DiezelBrown/RC-Crawler-Control-Telemetry-Platform/hardware/README.MD

# Hardware

## Chassis & Structure
- Custom welded steel chassis
- 5/16 in steel tubing
- 3/16 in steel tubing
- Pothyes CNC aluminum center frame brace / skid plate / transmission mount

## Drivetrain
- INJORA complete SCX10 II gearbox transmission
- 13T pinion gear
- Alloy front steering axle with steel gears (SCX10 II)
- Alloy rear axle with steel gears (SCX10 II)
- MEUS Racing SCX10 II 313 mm link set
- HopsupRC steel driveshaft set (85–122 mm and 95–137 mm)
- HOPLEX heavy-duty driveshaft (125–185 mm)

## Suspension & Steering
- INJORA DRX 100 mm dual-rate oil shocks (4)
- LJWRC 30 kg waterproof digital steering servo

## Wheels & Tires
- 1.9 in aluminum beadlock wheels
- 4.61 in soft rubber crawler tires

## Power System
- HobbyFans S3650 4300KV brushless motor
- HobbyFans 60A waterproof brushless ESC
- ESC programming card
- OVONIC 2S 7.4V 5200 mAh 50C LiPo battery
- Buck converter (5V power for ESP32)

## Radio System
- DumboRC X4 transmitter
- DumboRC X6F receiver

## Telemetry System
- ESP32 DevKit V1
- Battery voltage sensor
- DS18B20 waterproof temperature sensor
- Hall-effect RPM sensor
- BNO055 IMU *(planned)*
- Bluetooth mobile application *(in development)*
- Custom telemetry PCB *(planned)*

## Fasteners & Hardware
- 25 mm mounting screws
- Assorted metric screws
- Lock nuts
- Servo horn
- Steering linkage hardware
- Shock mounting hardware

## Wiring & Electronics
- Breadboard (prototype)
- Jumper wires (prototype)
- Silicone wire *(planned)*
- JST connectors *(planned)*
