DiezelBrown/RC-Crawler-Control-Telemetry-Platform/mobile_app/rc_crawler_dashboard/README.md

# RC Crawler Telemetry Dashboard

Flutter mobile application for monitoring the Custom RC Crawler Telemetry System in real time.

## Features

- Live Bluetooth Low Energy (BLE) connection
- Vehicle speed display
- Wheel RPM monitoring
- Battery voltage
- Motor temperature
- Pitch and roll angle visualization
- Connection status indicator

## Hardware

- ESP32
- BNO055 IMU
- Hall Effect Sensor
- DS18B20 Temperature Sensor
- Battery Voltage Monitor

## Technologies

- Flutter
- Dart
- Bluetooth Low Energy (BLE)

## Status

🚧 In Development

Current version supports live telemetry from the ESP32.

Future updates:
- Data logging
- Battery percentage
- Multiple telemetry pages
- Firmware updates over BLE
