DiezelBrown/RC-Crawler-Control-Telemetry-Platform/hardware/pinout.md

# GPIO Assignments

| GPIO Pin | Function |
|---|---|
| GPIO34 | Battery Voltage Sensor |
| GPIO27 | DS18B20 Temperature Sensor |
| GPIO26 | Hall Effect Sensor |
| TBD | BNO055 SDA *(Planned)* |
| TBD | BNO055 SCL *(Planned)* |
