DiezelBrown/RC-Crawler-Control-Telemetry-Platform/docs/updates/2026-06-30-roll-cage-completed.pdf

Project Update – June 30, 2026

Today I completed the fabrication of the roll cage for my custom RC crawler. With the structural components now finished, I am beginning development of the telemetry system before permanently mounting the roll cage to the chassis. This approach provides easier access to electronics, wiring, and sensors during testing and debugging.

The next phase of the project will focus on integrating an ESP32 microcontroller with sensors to monitor key vehicle data such as motor RPM, battery voltage, speed, and motor temperature. Once the telemetry hardware and software have been tested and verified, I will permanently mount the roll cage and complete the final electronics installation.

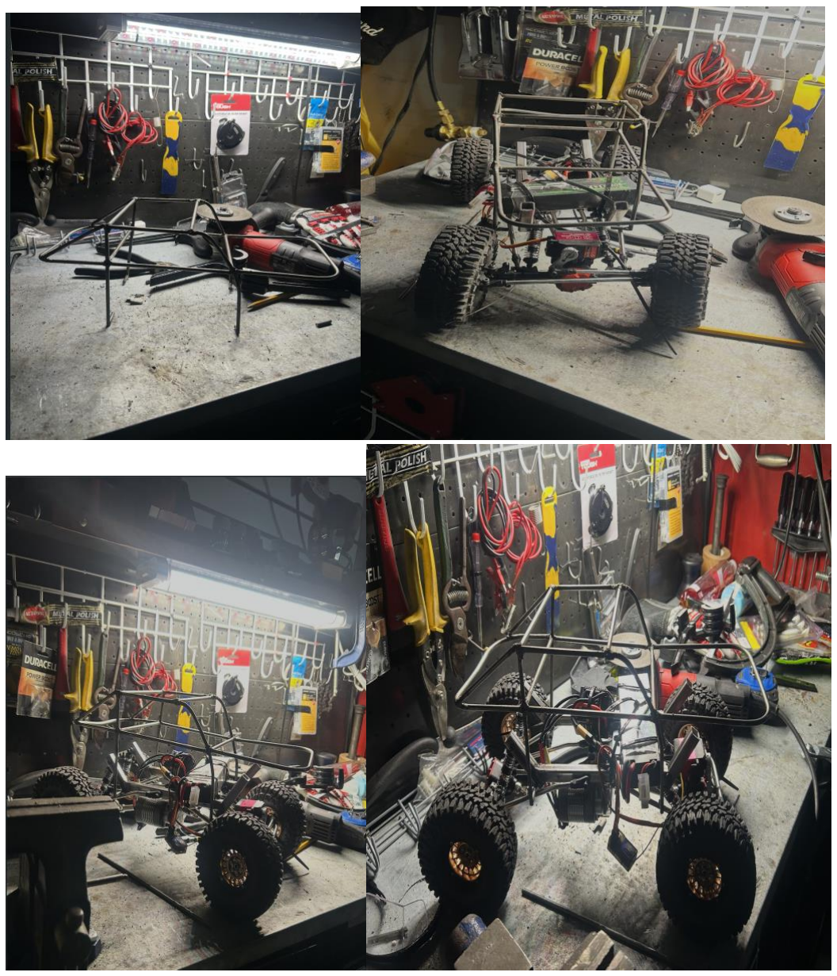
[picture p7: figure]
