DiezelBrown/RC-Crawler-Control-Telemetry-Platform/photos/early-development-roll-cage.jpeg

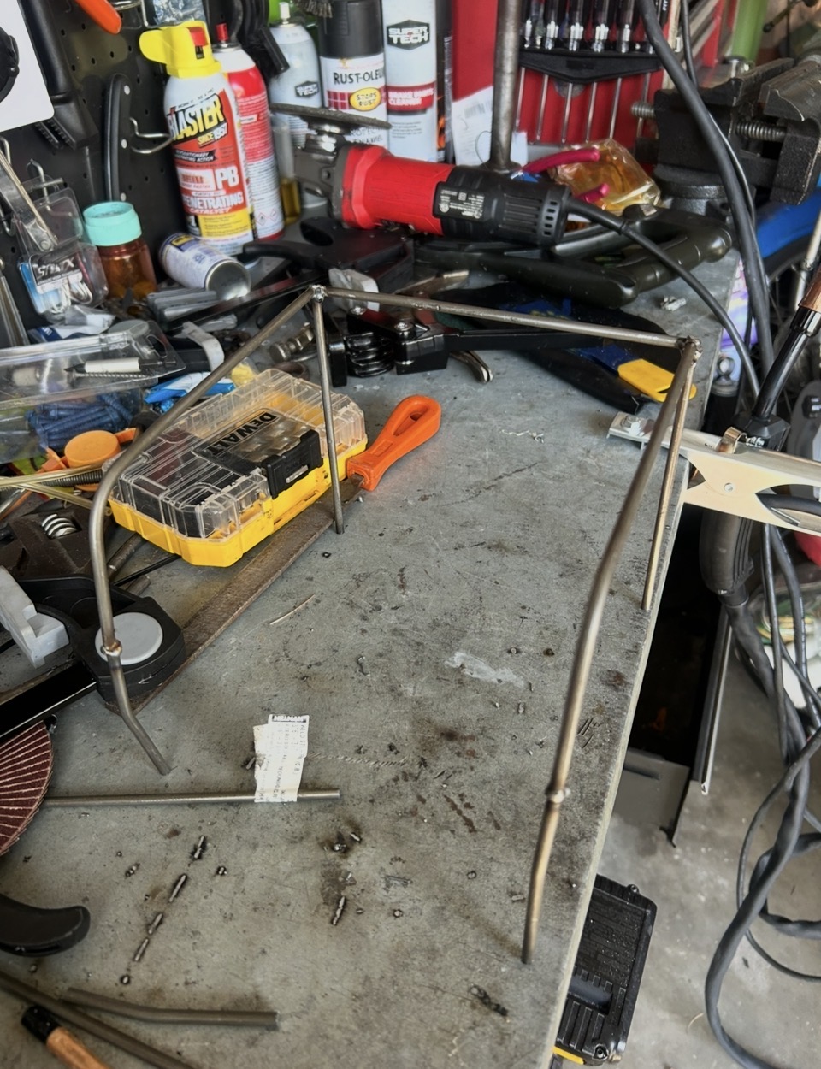
photos/early-development-roll-cage.jpeg
