DiezelBrown/RC-Crawler-Control-Telemetry-Platform/photos/IMG_4010.jpeg

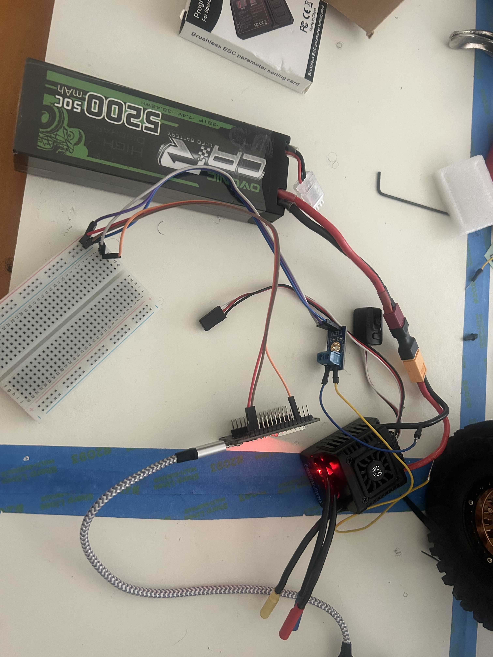
photos/IMG_4010.jpeg
