DiezelBrown/RC-Crawler-Control-Telemetry-Platform/photos/IMG_4015.jpeg

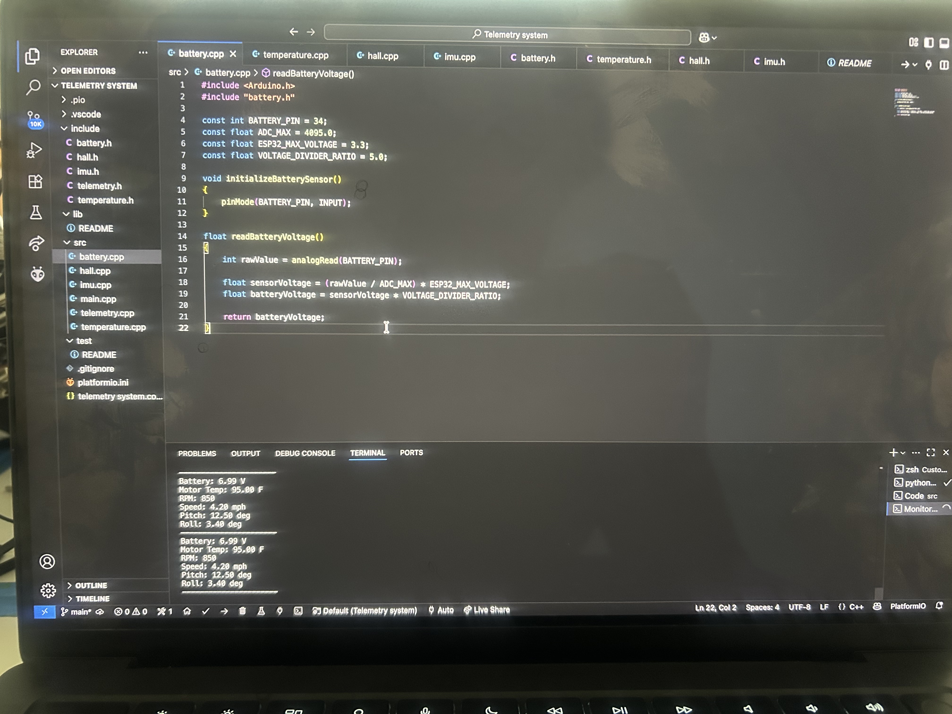
photos/IMG_4015.jpeg
