DiezelBrown/RC-Crawler-Control-Telemetry-Platform/photos/kicad-pcb-design-01.jpeg

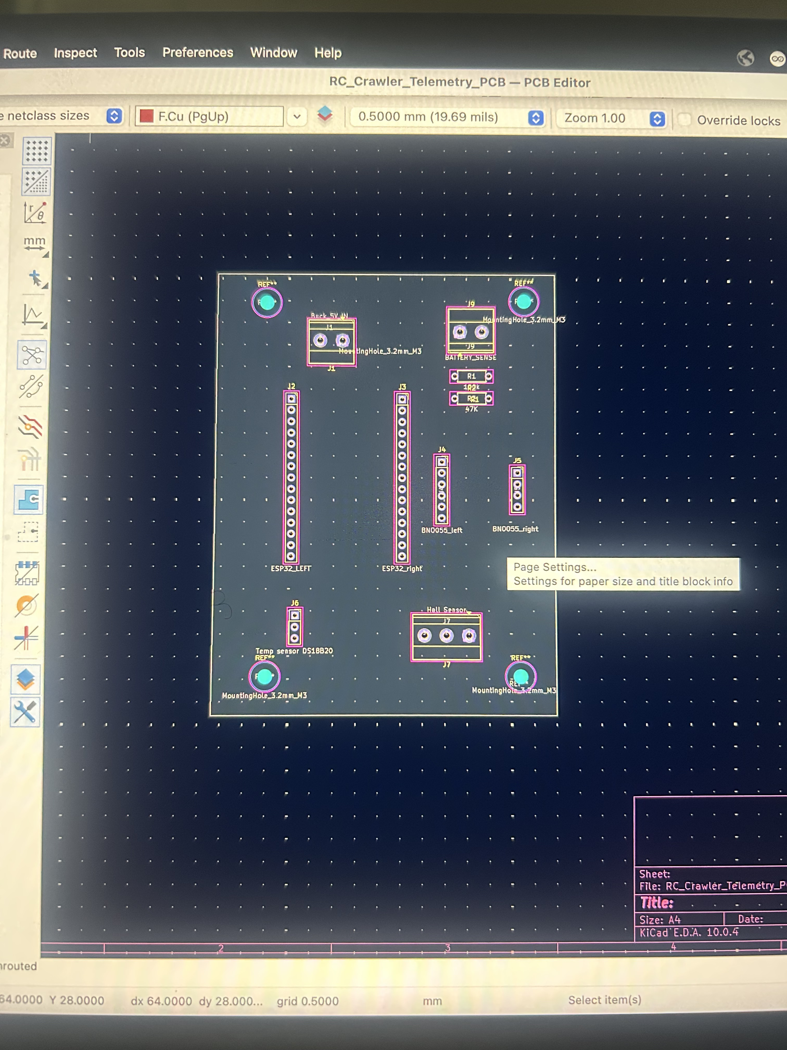
photos/kicad-pcb-design-01.jpeg
