DiezelBrown/RC-Crawler-Control-Telemetry-Platform/photos/layout.jpg

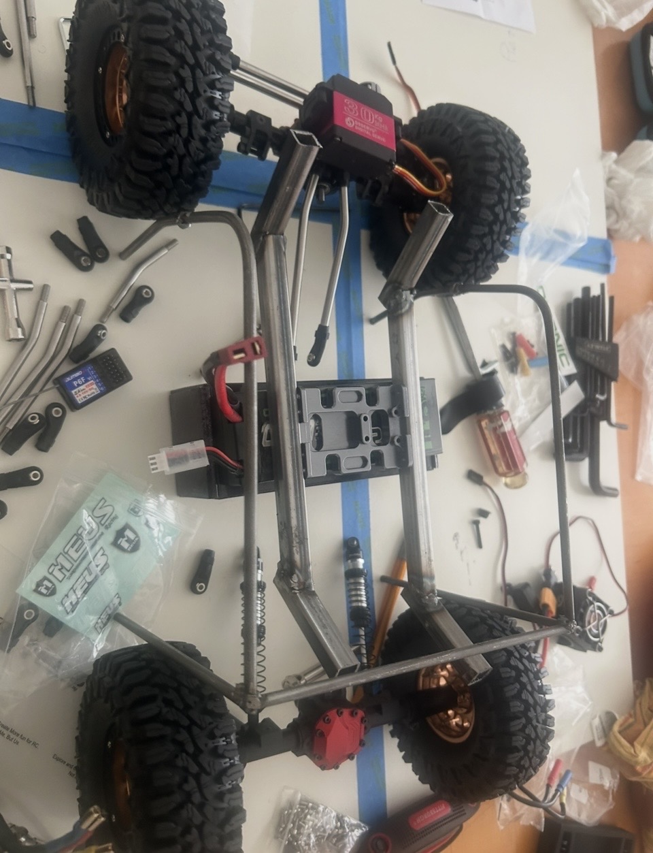
photos/layout.jpg
