DiezelBrown/RC-Crawler-Control-Telemetry-Platform/photos/Transmission.jpg

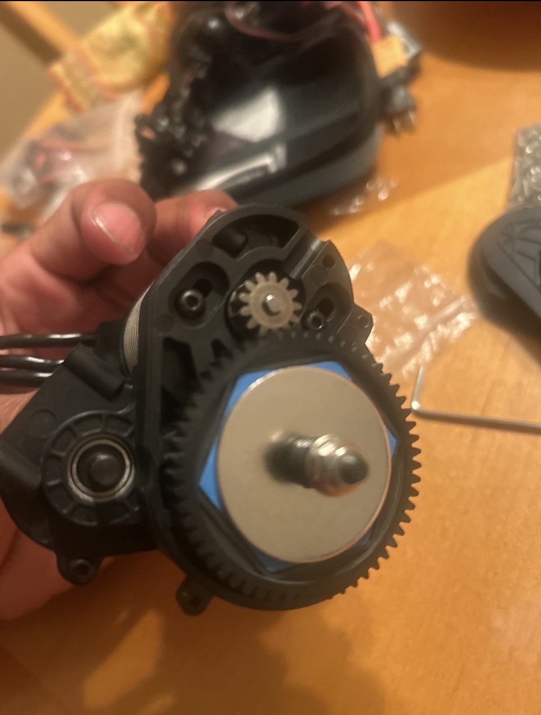
photos/Transmission.jpg
