DiezelBrown/RC-Crawler-Control-Telemetry-Platform/hardware/BOM.md

# Bill of Materials (BOM)

This document lists the major components used to build the Custom RC Crawler Telemetry System.

---

# Chassis & Structure

| Component | Description | Status |
|---|---|---|
| Steel Chassis | Custom welded steel chassis | Installed |
| Steel Tubing | 5/16 in steel tubing | Installed |
| Steel Tubing | 3/16 in steel tubing | Installed |
| Center Frame Brace | Pothyes CNC aluminum center frame brace / skid plate / transmission mount | Installed |

---

# Drivetrain

| Component | Description | Status |
|---|---|---|
| Transmission | INJORA SCX10 II complete gearbox | Installed |
| Pinion Gear | 13T steel pinion gear | Installed |
| Front Axle | Alloy steering axle with steel gears (SCX10 II) | Installed |
| Rear Axle | Alloy axle with steel gears (SCX10 II) | Installed |
| Link Set | MEUS Racing SCX10 II 313 mm links | Installed |
| Driveshaft | HopsupRC steel driveshaft set | Installed |
| Driveshaft | HOPLEX heavy-duty driveshaft | Installed |

---

# Suspension & Steering

| Component | Description | Status |
|---|---|---|
| Shocks | INJORA DRX 100 mm dual-rate oil shocks (4) | Installed |
| Steering Servo | LJWRC 30 kg waterproof digital servo | Installed |

---

# Wheels & Tires

| Component | Description | Status |
|---|---|---|
| Wheels | 1.9 in aluminum beadlock wheels | Installed |
| Tires | 4.61 in soft rubber crawler tires | Installed |

---

# Power System

| Component | Description | Status |
|---|---|---|
| Motor | HobbyFans S3650 4300KV brushless motor | Installed |
| ESC | HobbyFans 60A waterproof brushless ESC | Installed |
| Programming Card | HobbyFans ESC programming card | Installed |
| Battery | OVONIC 2S 7.4V 5200mAh 50C LiPo | Installed |

---

# Radio System

| Component | Description | Status |
|---|---|---|
| Transmitter | DumboRC X4 | Installed |
| Receiver | DumboRC X6F | Installed |

---

# Telemetry Electronics

| Component | Description | Status |
|---|---|---|
| Microcontroller | ESP32 DevKit V1 | Installed |
| Battery Sensor | Battery voltage sensor module | Installed |
| Temperature Sensor | DS18B20 waterproof sensor | Installed |
| RPM Sensor | Hall-effect sensor | Installed |
| Breadboard | Prototype wiring | Installed |
| IMU | BNO055 orientation sensor | Planned |
| Buck Converter | 5V regulator for ESP32 | Planned |
| Custom PCB | Telemetry PCB | Planned |

---

# Fasteners & Hardware

| Component | Description | Status |
|---|---|---|
| Screws | 25 mm mounting screws | Installed |
| Fasteners | Assorted metric screws | Installed |
| Lock Nuts | Metric lock nuts | Installed |
| Steering Hardware | Servo horn and steering linkage | Installed |
| Shock Hardware | Shock mounting hardware | Installed |
