DiezelBrown/RC-Crawler-Control-Telemetry-Platform/photos/assembled-pcb.jpeg

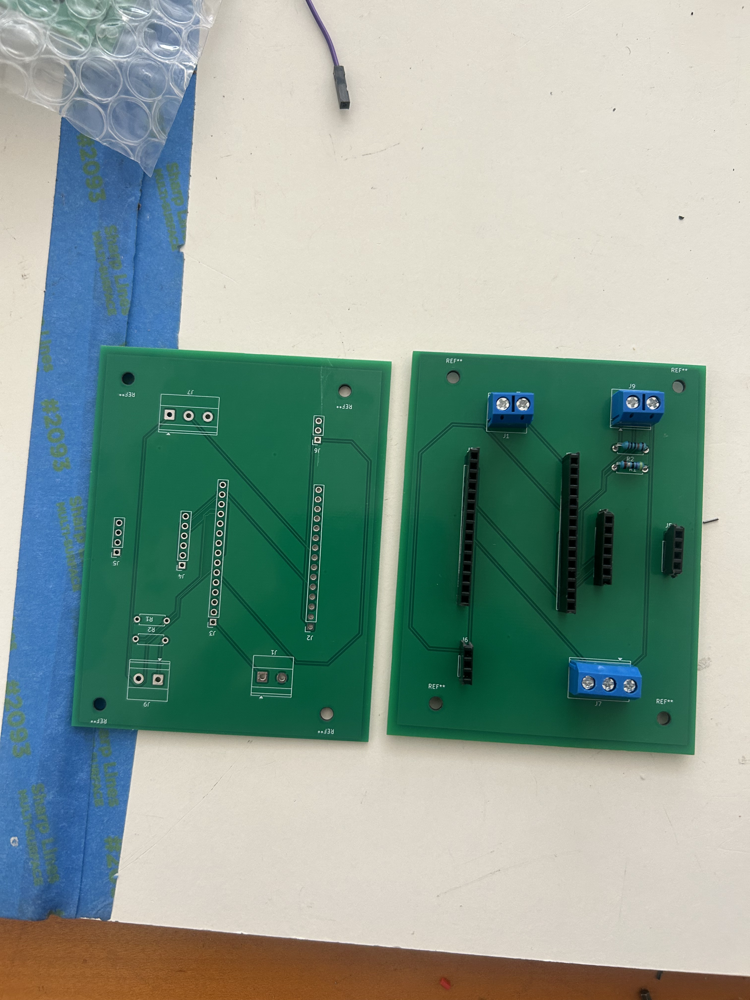
photos/assembled-pcb.jpeg
