DiezelBrown/RC-Crawler-Control-Telemetry-Platform/photos/Wiring.jpeg

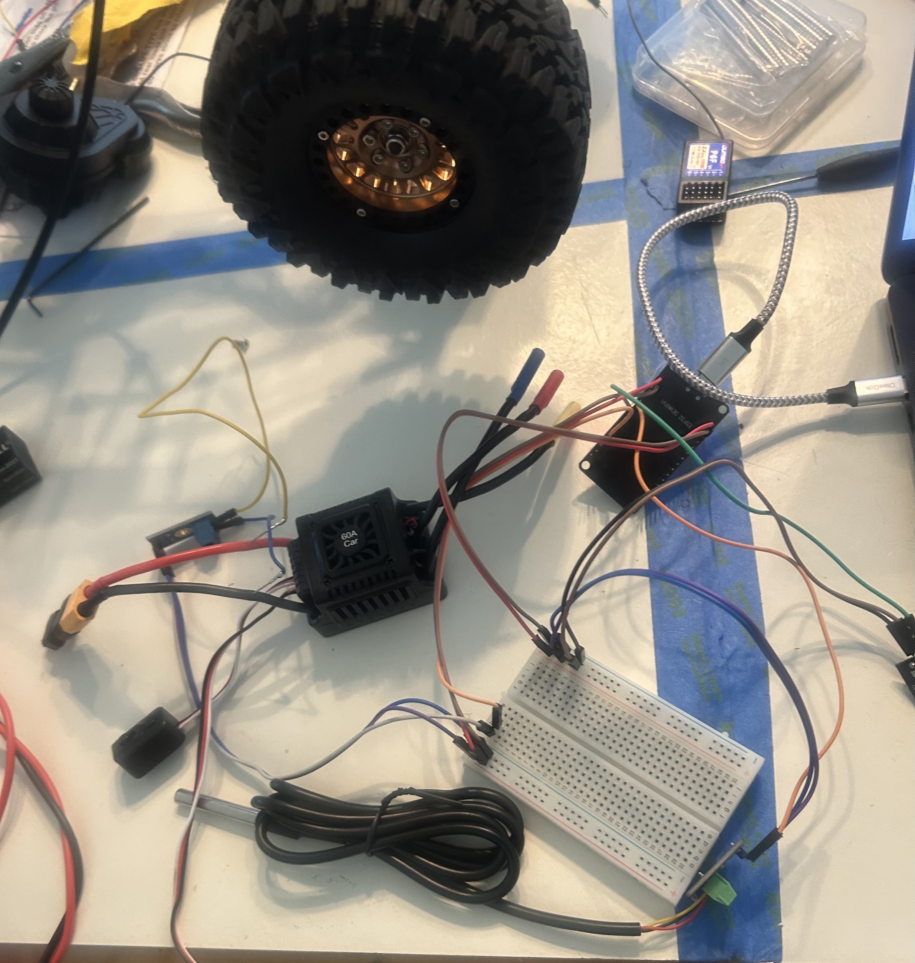
photos/Wiring.jpeg
