DiezelBrown/RC-Crawler-Control-Telemetry-Platform/docs/updates/2026-06-29-drivetrain-testing.pdf

## June 29, 2026 – First Driving Test

Today, I completed the first successful driving test of the RC crawler. The vehicle is currently operating in 2WD and is driven in reverse because the motor was mounted in an alternate orientation to accommodate the steep front driveshaft angles.

This test confirmed that the drivetrain, steering, and suspension systems are functional while identifying several areas for improvement. The primary objectives moving forward are to optimize the drivetrain layout, restore normal forward operation, and complete the transition to a fully functional 4WD drivetrain.

## Key Lessons Learned

- The current drivetrain configuration operates reliably but requires reverse motor orientation.
- Drivetrain geometry has a significant impact on driveshaft operating angles.
