DiezelBrown/RC-Crawler-Control-Telemetry-Platform/hardware/PCB/RC_Crawler_Telemetry_PCB/RC_Crawler_Telemetry_PCB.kicad_pcb

## KiCad design hardware/PCB/RC_Crawler_Telemetry_PCB/RC_Crawler_Telemetry_PCB.kicad_pcb (2026-07-17)

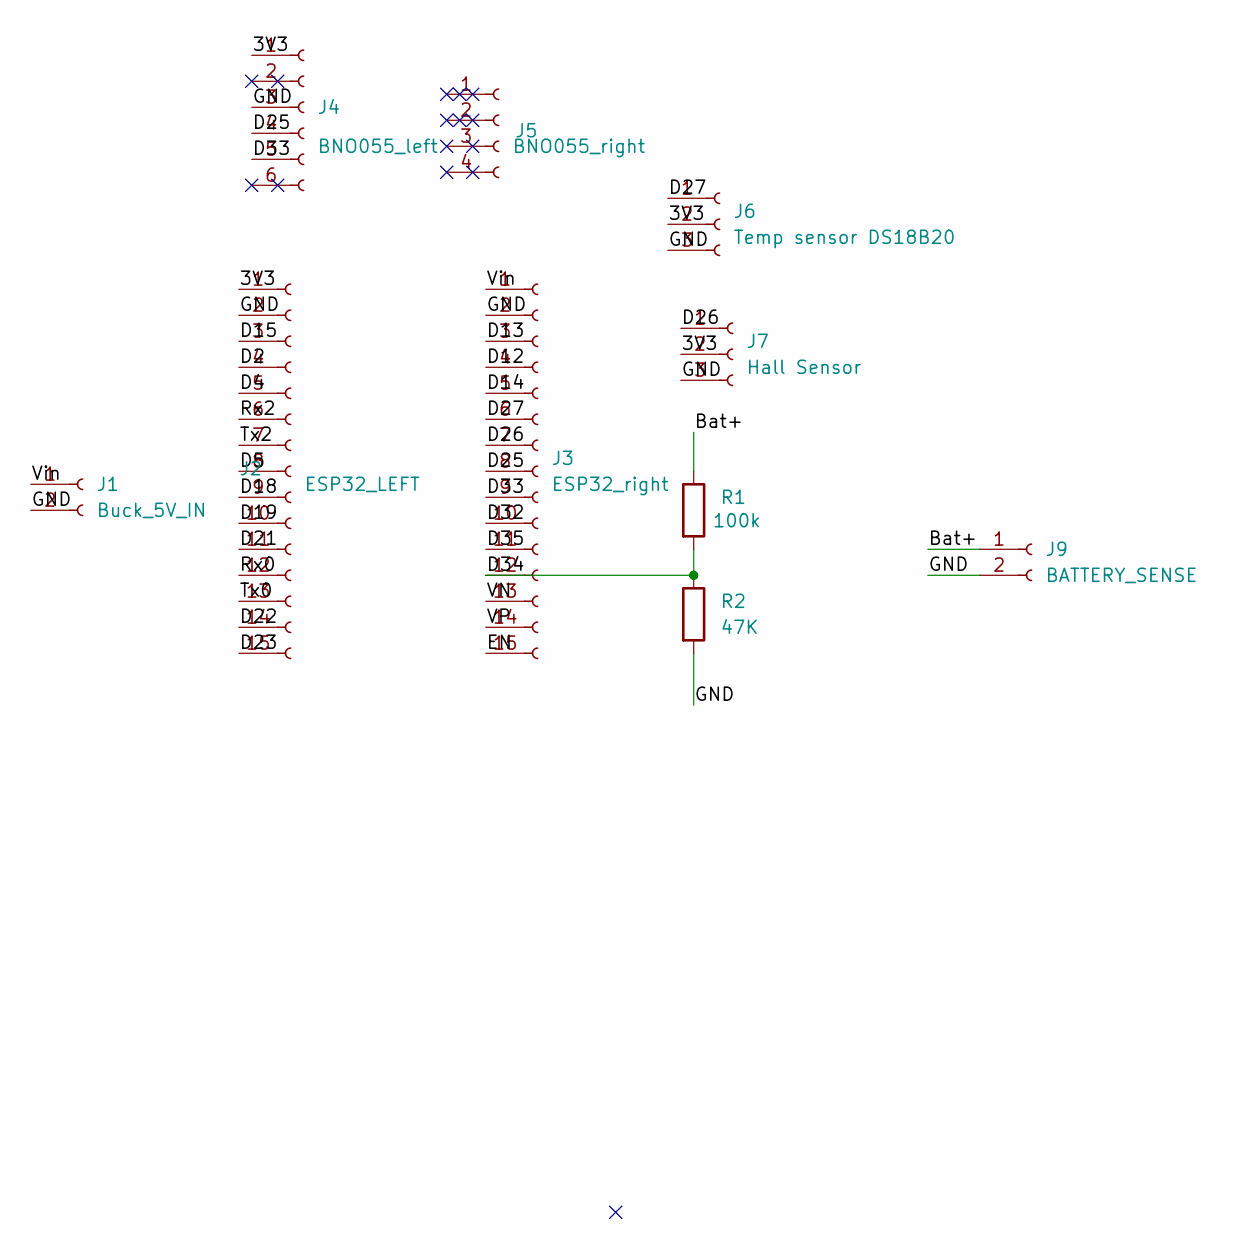
[picture p17: schematic RC_Crawler_Telemetry_PCB.kicad_sch]

Parts:
J1: Buck_5V_IN; TerminalBlock_Phoenix_MKDS-1,5-2_1x02_P5.00mm_Horizontal
J2: ESP32_LEFT; PinSocket_1x15_P2.54mm_Vertical
J3: ESP32_right; PinSocket_1x15_P2.54mm_Vertical
J4: BNO055_left; PinSocket_1x06_P2.54mm_Vertical
J5: BNO055_right; PinSocket_1x04_P2.54mm_Vertical
J6: Temp sensor DS18B20; PinSocket_1x03_P2.54mm_Vertical
J7: Hall Sensor; TerminalBlock_Phoenix_MKDS-1,5-3_1x03_P5.00mm_Horizontal
J9: BATTERY_SENSE; TerminalBlock_Phoenix_MKDS-1,5-2_1x02_P5.00mm_Horizontal
R1: 100k; R_Axial_DIN0207_L6.3mm_D2.5mm_P7.62mm_Horizontal
R2: 47K; R_Axial_DIN0207_L6.3mm_D2.5mm_P7.62mm_Horizontal

Connections:
/3V3: J2.1, J4.1, J6.2, J7.2
/Bat+: J9.1, R1.1
/D2: J2.4
/D4: J2.5
/D5: J2.8
/D12: J3.4
/D13: J3.3
/D14: J3.5
/D15: J2.3
/D18: J2.9
/D19: J2.10
/D21: J2.11
/D22: J2.14
/D23: J2.15
/D25: J3.8, J4.4
/D26: J3.7, J7.1
/D27: J3.6, J6.1
/D32: J3.10
/D33: J3.9, J4.5
/D34: J3.12, R1.2, R2.1
/D35: J3.11
/EN: J3.15
/GND: J1.2, J2.2, J3.2, J4.3, J6.3, J7.3, J9.2, R2.2
/Rx0: J2.12
/Rx2: J2.6
/Tx0: J2.13
/Tx2: J2.7
/VN: J3.13
/VP: J3.14
/Vin: J1.1, J3.1

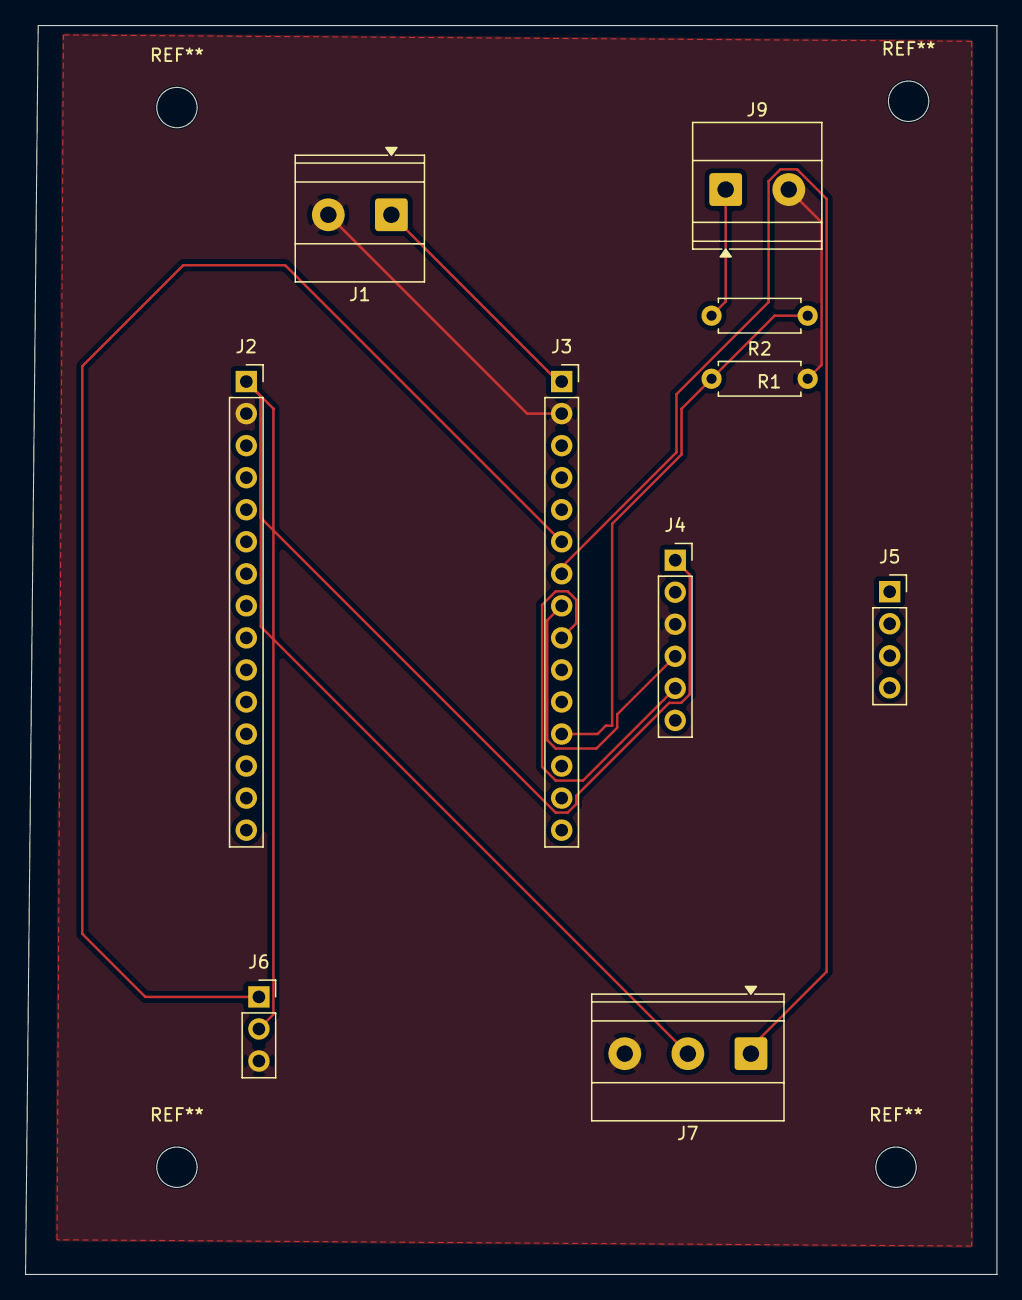
[picture p18: board RC_Crawler_Telemetry_PCB.kicad_pcb from above]

Board: 2 copper layers, 77.0 x 99.0 mm, 10 parts (0 on the bottom side), 9 nets.
