DiezelBrown/RC-Crawler-Control-Telemetry-Platform/(commit log)

2026-06-16 Update .gitignore for ESP32 C project
2026-06-16 Add parts list and assembly notes for RC crawler
    Add hardware directory
2026-06-16 Project documentation, wiring diagrams, testing results, and development notes.
2026-06-16 Create READ.ME
    Project documentation, wiring diagrams, testing results, and development notes.
2026-06-17 Early development
    Chassis development and layout
2026-06-22 Update README with parts list and assembly notes
    Added detailed parts list and assembly notes for the RC crawler, including chassis, drivetrain, suspension, electronics, and planned telemetry system.
2026-06-22 suspension installed
    In the photos I only have the front axle working Im going to install a longer rear driveshaft and then will begin working on my roll cage again
2026-06-22 Update README with RC crawler details and telemetry system
    Added detailed sections for chassis, drivetrain, suspension, wheels, electronics, telemetry system, and hardware.
2026-06-30 test run 6/29
    Today I was able to do the first full test run with my rc car. I the car right now is only running in 2wd and driving in reverse due to the motor having to be mounted differently due to the steep drive shaft angles.
2026-06-30 First test run 6/29
    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
2026-07-05 Revise current status section in README
    Updated project status with completed tasks and pending integrations.
2026-07-05 Add PlatformIO telemetry firmware framework
2026-07-07 Add live battery voltage telemetry module
2026-07-07 images of testing voltage sensor
2026-07-08 Wiring with breadboard
    Just testing components
2026-07-08 Rename IMG_4016.jpeg to Voltage_sensor_test .jpeg
2026-07-08 Revise hardware README structure and content
    Updated README to reflect new hardware and system organization, including sections for Power System, Radio System, and Telemetry System.
2026-07-08 Add Bill of Materials for Custom RC Crawler
    Added a comprehensive Bill of Materials (BOM) for the Custom RC Crawler Telemetry System, detailing components used in various categories including chassis, drivetrain, suspension, power system, radio system, telemetry electronics, and fasteners.
2026-07-08 Add Wiring Guide for ESP32 telemetry system
    This document outlines the wiring connections for the ESP32 telemetry system, including details for various sensors and the planned PCB design.
2026-07-10 Revise README for better structure and clarity
    Updated README to enhance clarity and organization of features, technologies, current telemetry, repository structure, status, and future goals.
2026-07-14 Update project status for mobile app and PCB
2026-07-14 Revise project status in README
    Updated the status of the mobile application and custom KiCad PCB.
2026-07-15 Start KiCad telemetry PCB design
    [RC_Crawler_Telemetry_PCB.kicad_pcb, RC_Crawler_Telemetry_PCB.kicad_sch]
2026-07-15 Add sensor interfaces and battery monitoring circuit
    [RC_Crawler_Telemetry_PCB.kicad_sch]
2026-07-17 Complete first revision of telemetry PCB
    [RC_Crawler_Telemetry_PCB.kicad_pcb, RC_Crawler_Telemetry_PCB.kicad_sch]
2026-07-17 KiCad PCB
2026-09-17 Update telemetry function for final sensor implementation
2026-09-17 Integrate final sensor and BLE telemetry firmware
