DiezelBrown/RC-Crawler-Control-Telemetry-Platform/photos/kicad-pcb-design-02.jpeg

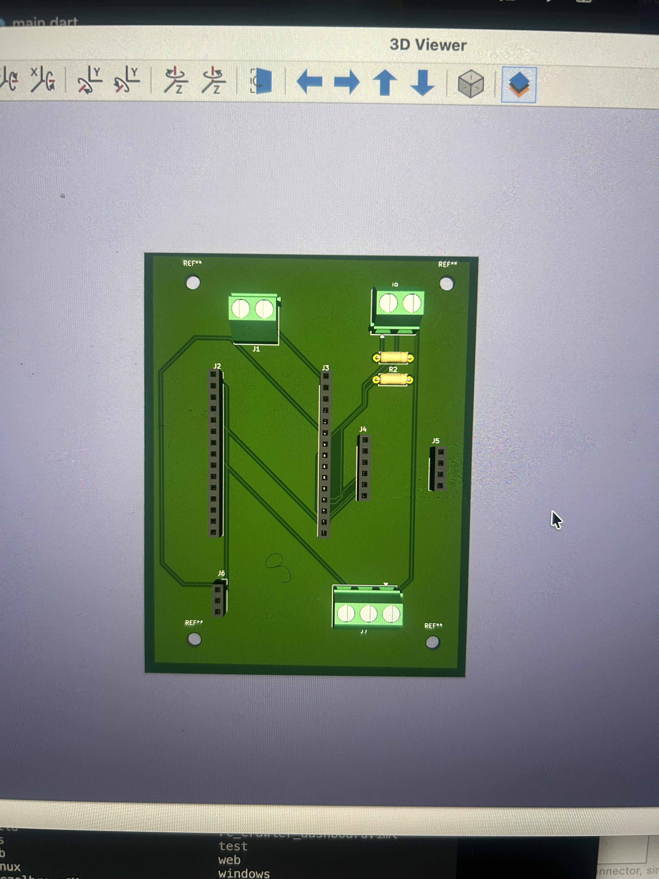
photos/kicad-pcb-design-02.jpeg
